fhc56/2026_NUEDC_G/2026G_STM32F103/STM32_UART_Test/code_hub.docx

#include "stm32f10x.h"

#include "ad9851.h"

#include "Delay.h" // 需实现Delay_us、Delay_s函数

/**

* @brief 初始化 AD9851 的 GPIO 控制引脚

*/

void ad9851_GPIOInit(void)

{

GPIO_InitTypeDef GPIO_InitStruct;

RCC_APB2PeriphClockCmd(ad9851_RCC, ENABLE);

GPIO_InitStruct.GPIO_Pin = ad9851_d7|ad9851_rest|ad9851_fq|ad9851_clk;

GPIO_InitStruct.GPIO_Speed = ad9851GPIO_spee;

GPIO_InitStruct.GPIO_Mode = ad9851GPIO_mode;

GPIO_Init(ad9851_pin_type, &GPIO_InitStruct);

// 初始电平置低

d7_ad9851(0);

rest_ad9851(0);

fq_ad9851(0);

clk_ad9851(0);

}

/**

* @brief AD9851 硬件复位（回归并口模式，切断内部电流源）

*/

void ad9851_reset(void)

{

clk_ad9851(0);

fq_ad9851(0);

rest_ad9851(0);

Delay_us(1);

rest_ad9851(1);

Delay_us(1);

rest_ad9851(0);

Delay_us(1);

}

/**

* @brief AD9851 复位并切换到串行通信模式

*/

void ad9851_reset_serial(void)

{

ad9851_reset();

clk_ad9851(0);

Delay_us(1);

clk_ad9851(1);

Delay_us(1);

clk_ad9851(0);

Delay_us(1);

fq_ad9851(0);

Delay_us(1);

fq_ad9851(1);

Delay_us(1);

fq_ad9851(0);

Delay_us(1);

}

/**

* @brief 内部频率计算转换函数

*/

uint32_t ad9851_fre_trun(double fre, uint8_t control)

{

double x = 4294967296.0; // 2^32

uint32_t fre_reg = 0;

double sys_clk = ad9851f_system;

if(control & 0x01) sys_clk *= 6;

if(sys_clk == 0) return 0;

fre_reg = (uint32_t)(x * fre / sys_clk);

return fre_reg;

}

/**

* @brief 内部相位控制字转换函数

*/

uint32_t ad9851_phase_trun(double phase, uint8_t control)

{

uint8_t phase_reg = 0;

phase = (phase < 0) ? 0 : (phase > 360) ? 360 : phase;

phase_reg = (uint8_t)(phase / 11.25);

return ((phase_reg << 3) | (control & 0x07));

}

/**

* @brief 标准单次频率/相位写入函数

*/

void ad9851_write(double fre, double phase, uint8_t control)

{

uint32_t fre_reg;

uint8_t phase_reg;

phase_reg = ad9851_phase_trun(phase, control);

fre_reg = ad9851_fre_trun(fre, control);

ad9851_reset_serial();

// 写入32位频率寄存器（LSB先行）

for(int i=0;i<32;i++)

{

d7_ad9851( (fre_reg >> i) & 0x01 );

clk_ad9851(1);

Delay_us(1);

clk_ad9851(0);

Delay_us(1);

}

// 写入8位相位/控制寄存器

for(int i=0;i<8;i++)

{

d7_ad9851( (phase_reg >> i) & 0x01 );

clk_ad9851(1);

Delay_us(1);

clk_ad9851(0);

Delay_us(1);

}

// FQ_UD锁存生效

fq_ad9851(1);

Delay_us(1);

fq_ad9851(0);

Delay_us(1);

}

/**

* @brief 驱使 AD9851 吐出一帧 10kHz 载波、1200bps 速率、单电源正半周分布的 2-ASK 数据包

*/

void AD9851_Send2ASKPacket(uint8_t d1, uint8_t d2, uint8_t d3, uint8_t d4)

{

uint8_t frame[6];

// 1. 组装标准 2-ASK 数据包：[帧头0x5A] + [4字节数据] + [1字节校验和]

frame[0] = 0x5A;

frame[1] = d1;

frame[2] = d2;

frame[3] = d3;

frame[4] = d4;

frame[5] = (d1 + d2 + d3 + d4) & 0xFF;

/////////// // === 动手加在大循环上方 ===

////////////////////

// 2. 1200bps 异步时序展开：每个 Bit 宽度要求约 833 微秒

for (int i = 0; i < 6; i++)

{

uint16_t uart_byte = (1 << 9) | (frame[i] << 1) | 0; // 起始位0 + 数据8位 + 停止位1

for (int bit = 0; bit < 10; bit++)

{

uint8_t current_bit = uart_byte & 0x01;

if (current_bit == 1)

{

// 发 1：让芯片上电正常工作，吐出符合要求的 10kHz 载波正弦波

ad9851_write(10000.0, 0.0, ad9851_fd | ad9851_on);

}

else

{

// 发 0：直接调用硬件复位，完全关闭模拟偏置，波形瞬间砸回并贴死在 0V 地线上

ad9851_reset();

//ad9851_write(0.0, 0.0, ad9851_fd | ad9851_on);

}

// ====== 修改位置 2：把循环内原有的 if-else 整体删掉，换成以下代码 ======

// 扣除上面串行写入函数执行花费的软件开销，精准维持 1200bps 码元宽度

Delay_us(740);

uart_byte >>= 1;

}

}

// 3. 全包发射结束：强制保持硬件复位，让平时不发信号的静默期死死贴在 0V 上

ad9851_reset();

}

#include "stm32f10x.h"

#include "ad9851.h"

#include "Delay.h" // 需实现Delay_us、Delay_s函数

/**

* @brief 初始化 AD9851 的 GPIO 控制引脚

*/

void ad9851_GPIOInit(void)

{

GPIO_InitTypeDef GPIO_InitStruct;

RCC_APB2PeriphClockCmd(ad9851_RCC, ENABLE);

GPIO_InitStruct.GPIO_Pin = ad9851_d7|ad9851_rest|ad9851_fq|ad9851_clk;

GPIO_InitStruct.GPIO_Speed = ad9851GPIO_spee;

GPIO_InitStruct.GPIO_Mode = ad9851GPIO_mode;

GPIO_Init(ad9851_pin_type, &GPIO_InitStruct);

// 初始电平置低

d7_ad9851(0);

rest_ad9851(0);

fq_ad9851(0);

clk_ad9851(0);

}

/**

* @brief AD9851 硬件复位（回归并口模式，切断内部电流源）

*/

void ad9851_reset(void)

{

clk_ad9851(0);

fq_ad9851(0);

rest_ad9851(0);

Delay_us(1);

rest_ad9851(1);

Delay_us(1);

rest_ad9851(0);

Delay_us(1);

}

/**

* @brief AD9851 复位并切换到串行通信模式

*/

void ad9851_reset_serial(void)

{

ad9851_reset();

clk_ad9851(0);

Delay_us(1);

clk_ad9851(1);

Delay_us(1);

clk_ad9851(0);

Delay_us(1);

fq_ad9851(0);

Delay_us(1);

fq_ad9851(1);

Delay_us(1);

fq_ad9851(0);

Delay_us(1);

}

/**

* @brief 内部频率计算转换函数

*/

uint32_t ad9851_fre_trun(double fre, uint8_t control)

{

double x = 4294967296.0; // 2^32

uint32_t fre_reg = 0;

double sys_clk = ad9851f_system;

if(control & 0x01) sys_clk *= 6;

if(sys_clk == 0) return 0;

fre_reg = (uint32_t)(x * fre / sys_clk);

return fre_reg;

}

/**

* @brief 内部相位控制字转换函数

*/

uint32_t ad9851_phase_trun(double phase, uint8_t control)

{

uint8_t phase_reg = 0;

phase = (phase < 0) ? 0 : (phase > 360) ? 360 : phase;

phase_reg = (uint8_t)(phase / 11.25);

return ((phase_reg << 3) | (control & 0x07));

}

/**

* @brief 标准单次频率/相位写入函数

*/

void ad9851_write(double fre, double phase, uint8_t control)

{

uint32_t fre_reg;

uint8_t phase_reg;

phase_reg = ad9851_phase_trun(phase, control);

fre_reg = ad9851_fre_trun(fre, control);

ad9851_reset_serial();

// 写入32位频率寄存器（LSB先行）

for(int i=0;i<32;i++)

{

d7_ad9851( (fre_reg >> i) & 0x01 );

clk_ad9851(1);

Delay_us(1);

clk_ad9851(0);

Delay_us(1);

}

// 写入8位相位/控制寄存器

for(int i=0;i<8;i++)

{

d7_ad9851( (phase_reg >> i) & 0x01 );

clk_ad9851(1);

Delay_us(1);

clk_ad9851(0);

Delay_us(1);

}

// FQ_UD锁存生效

fq_ad9851(1);

Delay_us(1);

fq_ad9851(0);

Delay_us(1);

}

/**

* @brief 驱使 AD9851 吐出一帧 10kHz 载波、1200bps 速率、单电源正半周分布的 2-ASK 数据包

*/

void AD9851_Send2ASKPacket(uint8_t d1, uint8_t d2, uint8_t d3, uint8_t d4)

{

uint8_t frame[6];

// 1. 组装标准 2-ASK 数据包：[帧头0x5A] + [4字节数据] + [1字节校验和]

frame[0] = 0x5A;

frame[1] = d1;

frame[2] = d2;

frame[3] = d3;

frame[4] = d4;

frame[5] = (d1 + d2 + d3 + d4) & 0xFF;

/////////// // === 动手加在大循环上方 ===

uint32_t freq_0_reg = ad9851_fre_trun(0.0, ad9851_fd | ad9851_on);

uint8_t phase_reg = ad9851_phase_trun(0.0, ad9851_fd | ad9851_on);

////////////////////

// 2. 1200bps 异步时序展开：每个 Bit 宽度要求约 833 微秒

for (int i = 0; i < 6; i++)

{

uint16_t uart_byte = (1 << 9) | (frame[i] << 1) | 0; // 起始位0 + 数据8位 + 停止位1

for (int bit = 0; bit < 10; bit++)

{

uint8_t current_bit = uart_byte & 0x01;

if (current_bit == 1)

{

// 发 1：让芯片上电正常工作，吐出符合要求的 10kHz 载波正弦波

ad9851_write(10000.0, 0.0, ad9851_fd | ad9851_on);

}

else

{

// 发 0：直接调用硬件复位，完全关闭模拟偏置，波形瞬间砸回并贴死在 0V 地线上

// ad9851_reset();

// 发 0：先通过串行把频率温柔地切到 0Hz（此时芯片还在串行工作模式下）

// 这样 DDS 内部的累加器会平滑停止，把正弦波能量收回，断绝尖峰

for(int k=0; k<32; k++) { d7_ad9851((freq_0_reg >> k) & 0x01); clk_ad9851(1); clk_ad9851(0); }

for(int k=0; k<8; k++) { d7_ad9851((phase_reg >> k) & 0x01); clk_ad9851(1); clk_ad9851(0); }

fq_ad9851(1); fq_ad9851(0); // 锁存 0Hz

// 随后立刻调用硬件复位，确保彻底切断偏置，完美贴死在你的基线上

ad9851_reset();

//Delay_us(100);

}

// 扣除上面串行写入函数执行花费的软件开销，精准维持 1200bps 码元宽度

Delay_us(740);

uart_byte >>= 1;

}

}

// 3. 全包发射结束：强制保持硬件复位，让平时不发信号的静默期死死贴在 0V 上

ad9851_reset();

}
